Alex-Markham/causal-chamber/hardware/lasercuts/lasercut_lt_mk_1.pdf

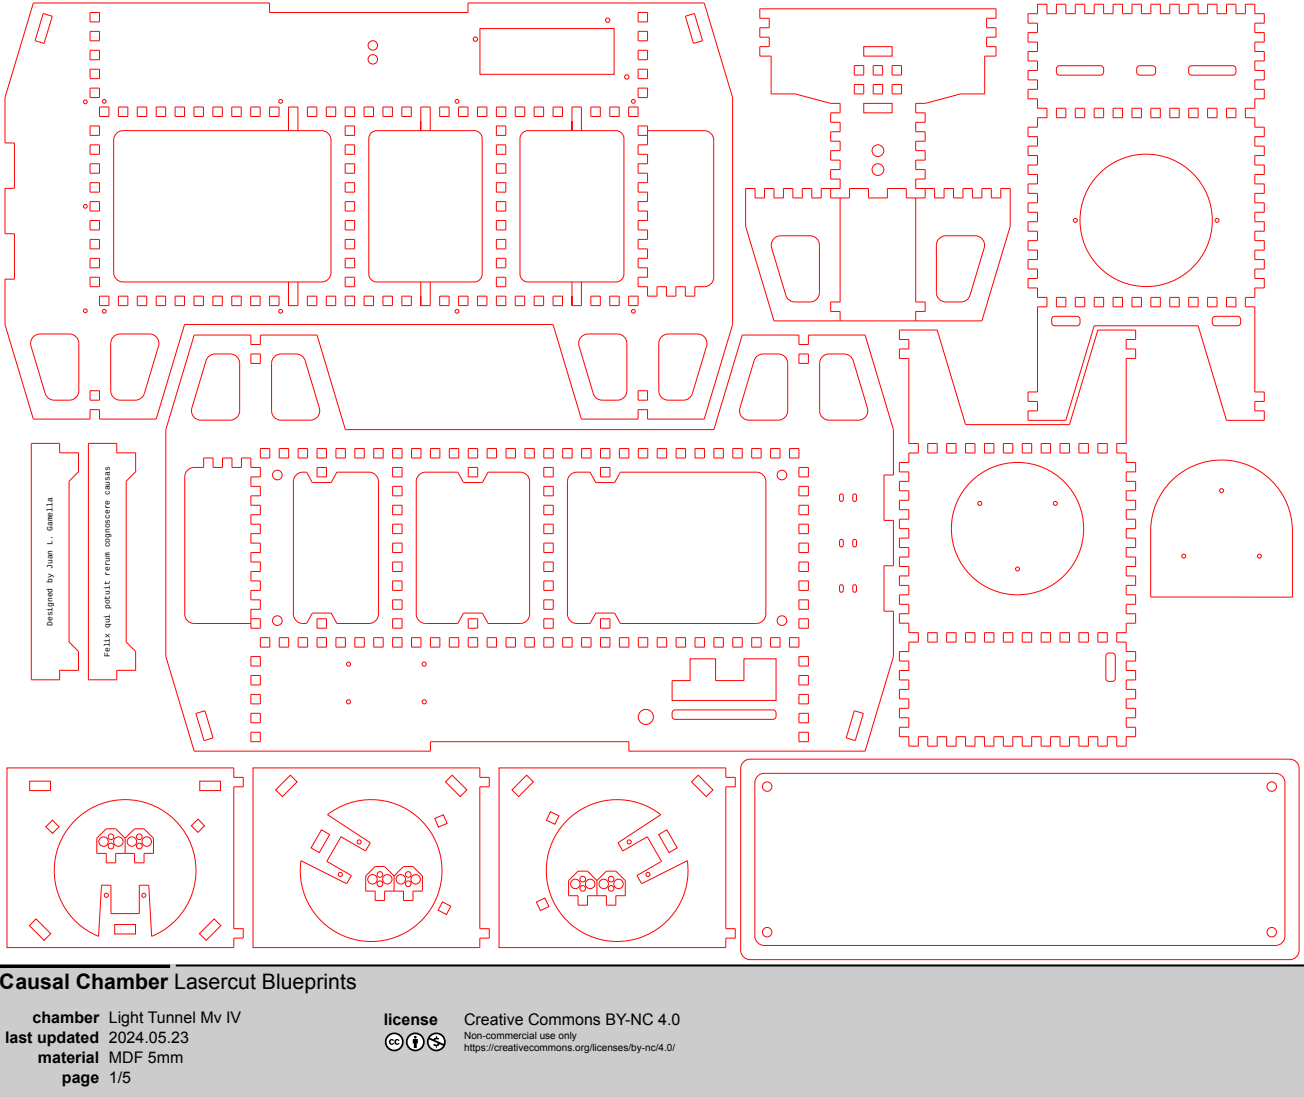
[picture p1: page 1]
chamber last updated material page; license; Creative Commons BY-NC 4.0

Felix qui potuit rerum cognoscere causas

Designed by Juan L. Gamella

Causal Chamber Lasercut Blueprints

Light Tunnel Mv IV
MDF 5mm

Non-commercial use only
https://creativecommons.org/licenses/by-nc/4.0/

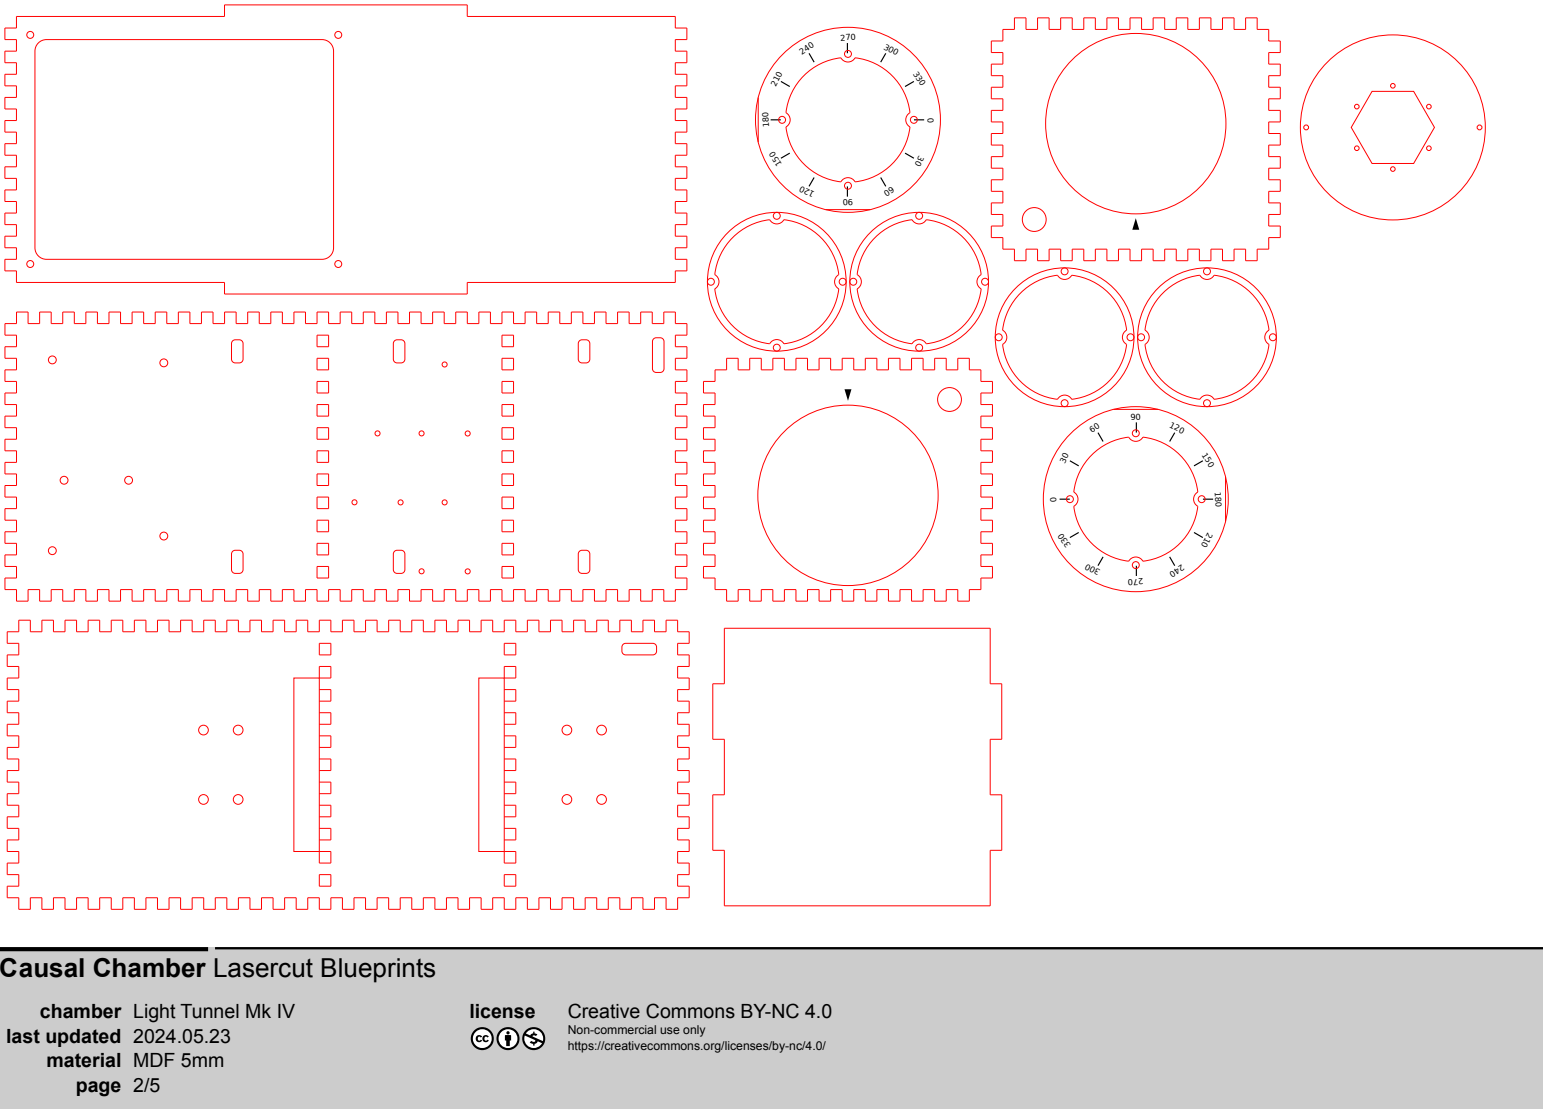
[picture p2: page 2]
chamber last updated; license; Creative Commons BY-NC 4.0

Causal Chamber Lasercut Blueprints

Light Tunnel Mk IV
MDF 5mm

Non-commercial use only
https://creativecommons.org/licenses/by-nc/4.0/

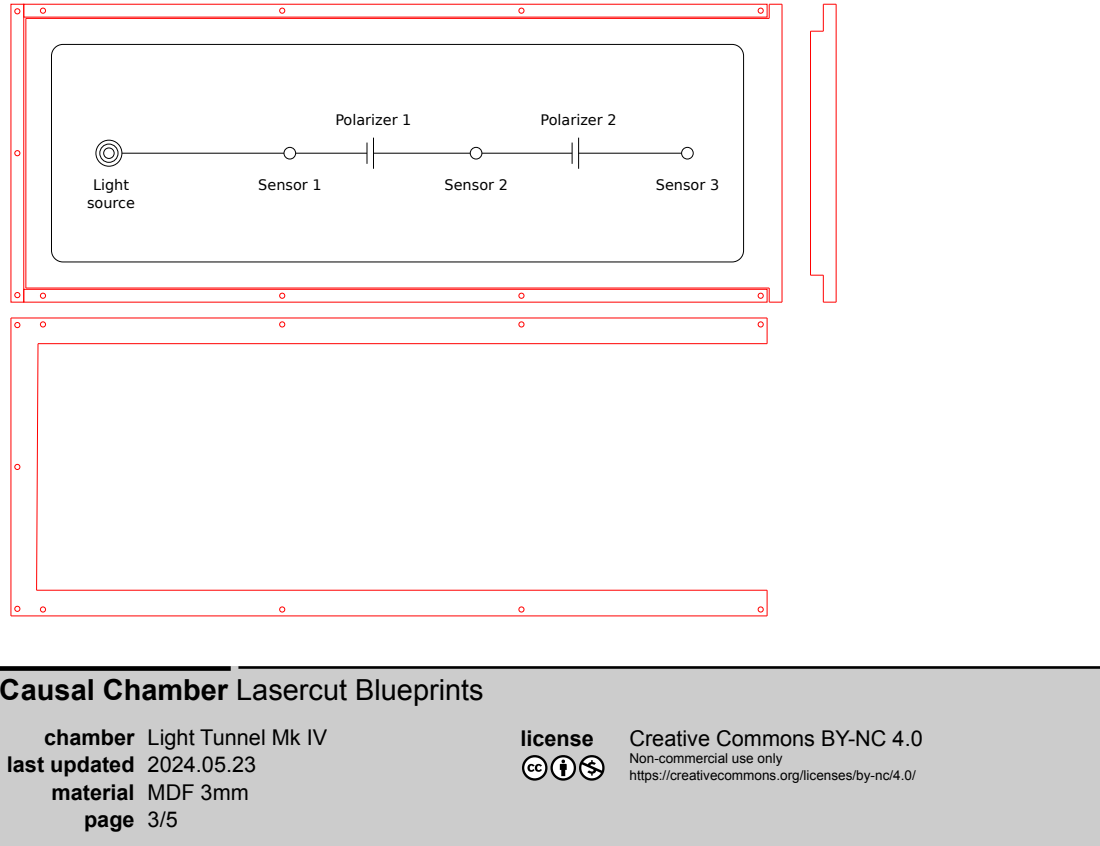
[picture p3: page 3]
chamber last updated; Sensor 1; Polarizer 1; Light source; Polarizer 2; Sensor 2; Sensor 3; license; Creative Commons BY-NC 4.0

Causal Chamber Lasercut Blueprints

Light Tunnel Mk IV
MDF 3mm

Non-commercial use only
https://creativecommons.org/licenses/by-nc/4.0/

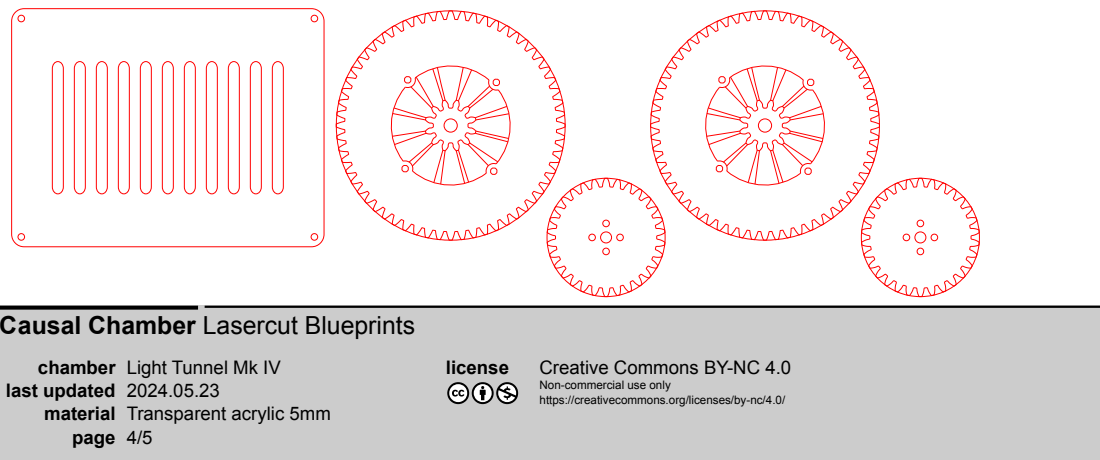
[picture p4: page 4]
chamber last updated material; license; Creative Commons BY-NC 4.0

Causal Chamber Lasercut Blueprints

Light Tunnel Mk IV
Transparent acrylic 5mm

Non-commercial use only
https://creativecommons.org/licenses/by-nc/4.0/

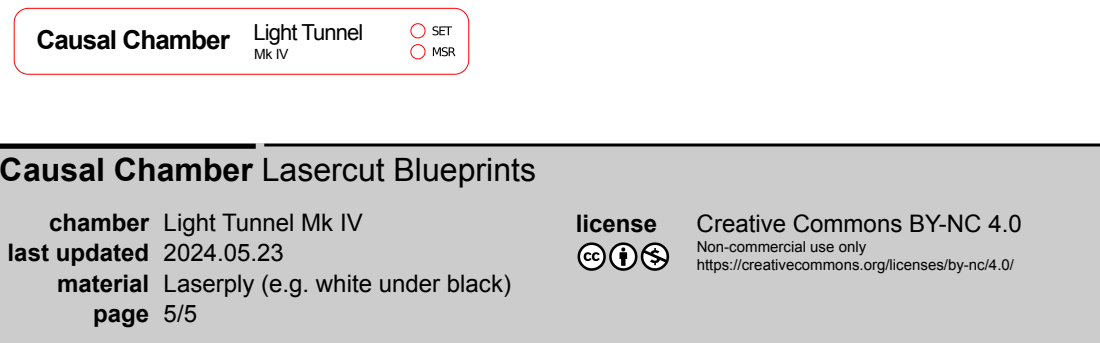
[picture p5: page 5]
chamber last updated material page; license; Creative Commons BY-NC 4.0

Causal Chamber Light Tunnel

Causal Chamber Lasercut Blueprints

Light Tunnel Mk IV
Laserply (e.g. white under black)

Non-commercial use only
https://creativecommons.org/licenses/by-nc/4.0/
