Alex-Markham/causal-chamber/hardware/lasercuts/lasercut_wt_mk_1.pdf

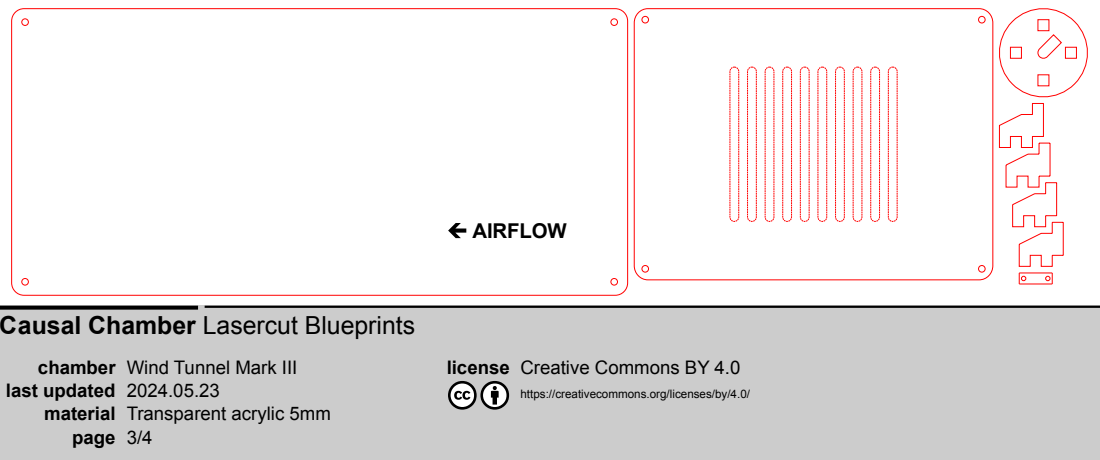
[picture p6: page 1]
AIRFLOW; chamber last updated material page

Causal Chamber Lasercut Blueprints

Wind Tunnel Mark III
Transparent acrylic 5mm

license Creative Commons BY 4.0

https://creativecommons.org/licenses/by/4.0/

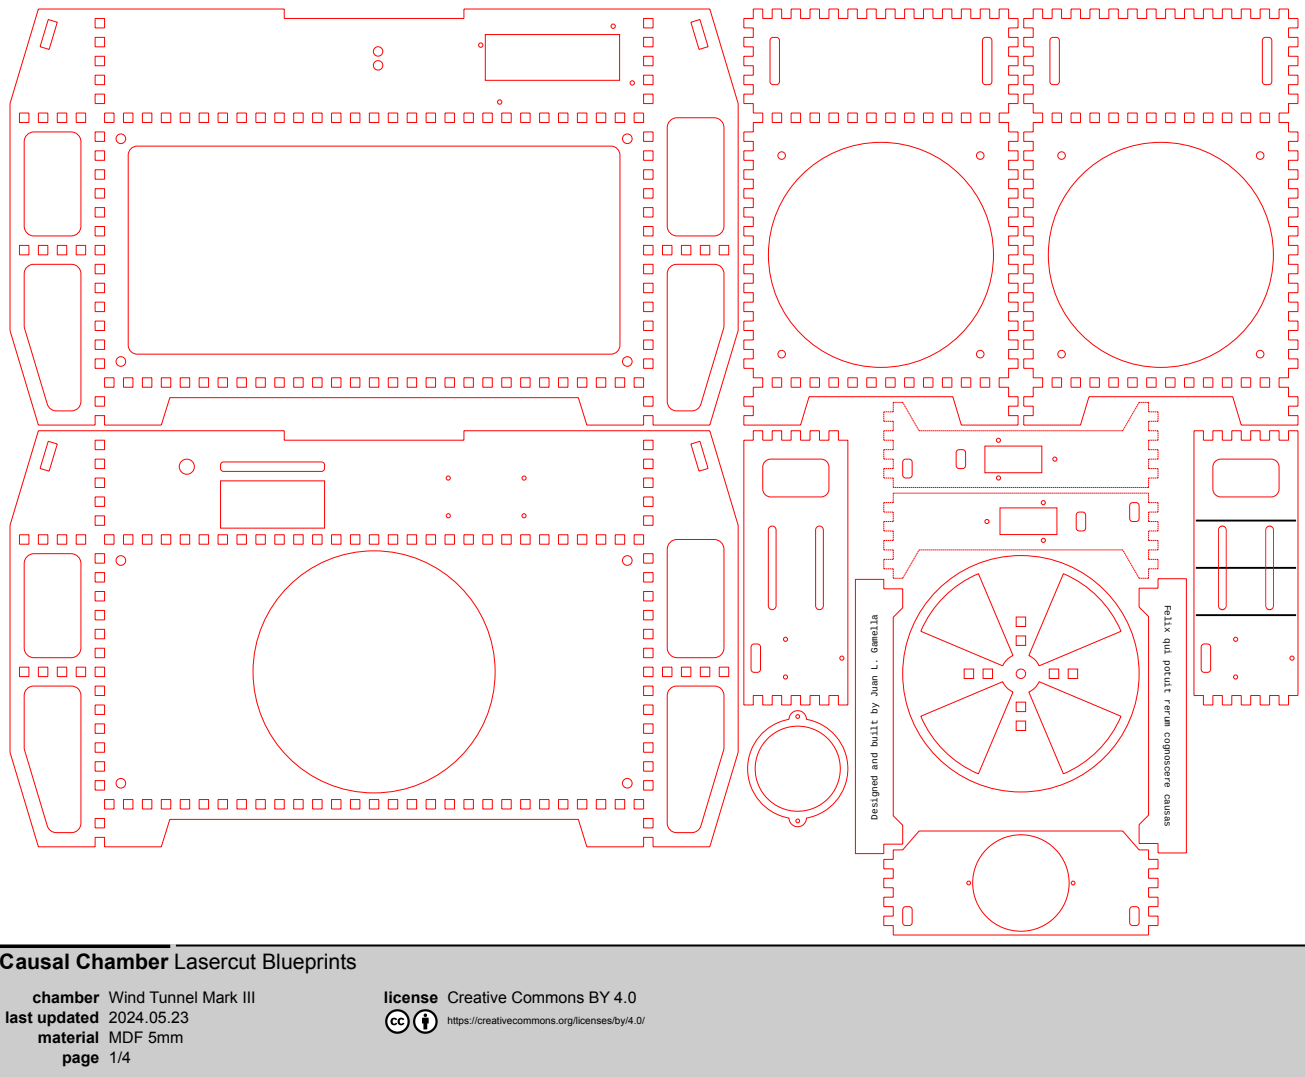
[picture p7: page 2]
chamber last updated material

Felix qui potuit rerum cognoscere causas

Designed and built by Juan L. Gamella

Causal Chamber Lasercut Blueprints

Wind Tunnel Mark III
MDF 5mm

license Creative Commons BY 4.0

https://creativecommons.org/licenses/by/4.0/

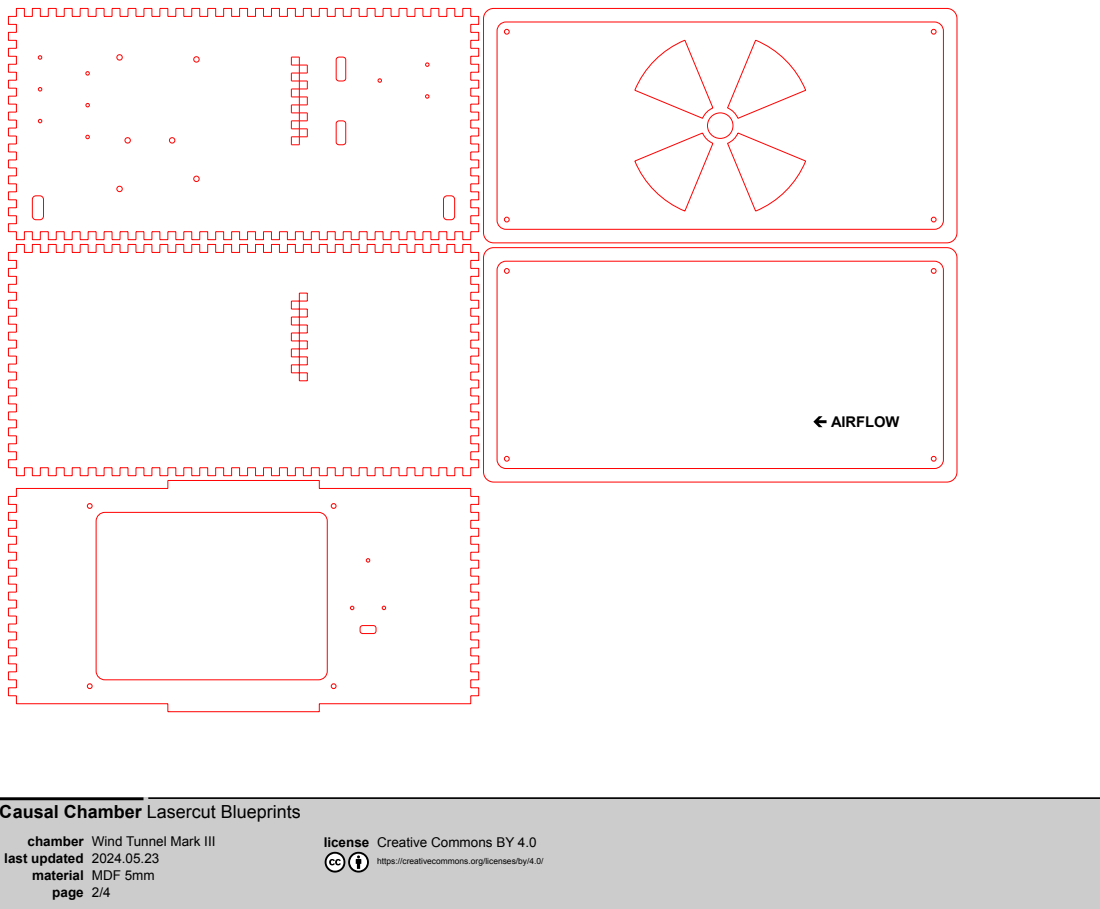
[picture p8: page 3]
AIRFLOW; chamber last updated material

Causal Chamber Lasercut Blueprints

Wind Tunnel Mark III
MDF 5mm

license Creative Commons BY 4.0

https://creativecommons.org/licenses/by/4.0/

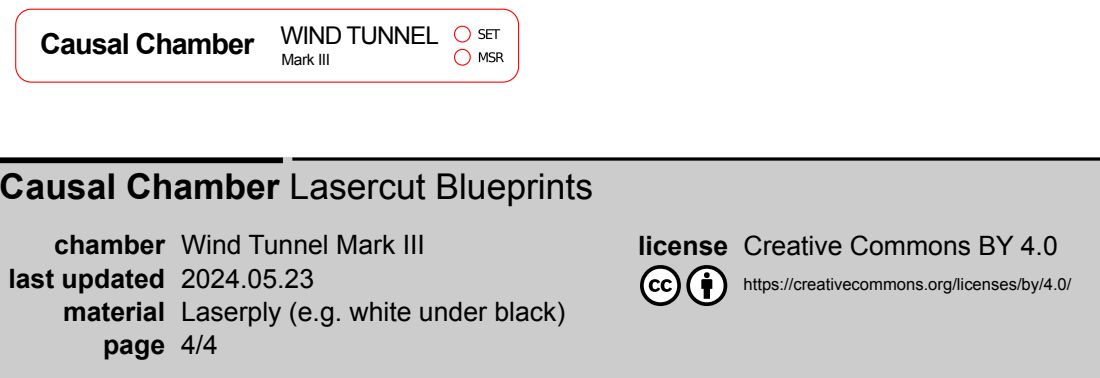
[picture p9: page 4]
Mark III; chamber last updated material page

Causal Chamber WIND TUNNEL

Causal Chamber Lasercut Blueprints

Wind Tunnel Mark III
Laserply (e.g. white under black)

license Creative Commons BY 4.0

https://creativecommons.org/licenses/by/4.0/
