Alex-Markham/causal-chamber/hardware/schematics/schematic_lt_mk_1.pdf

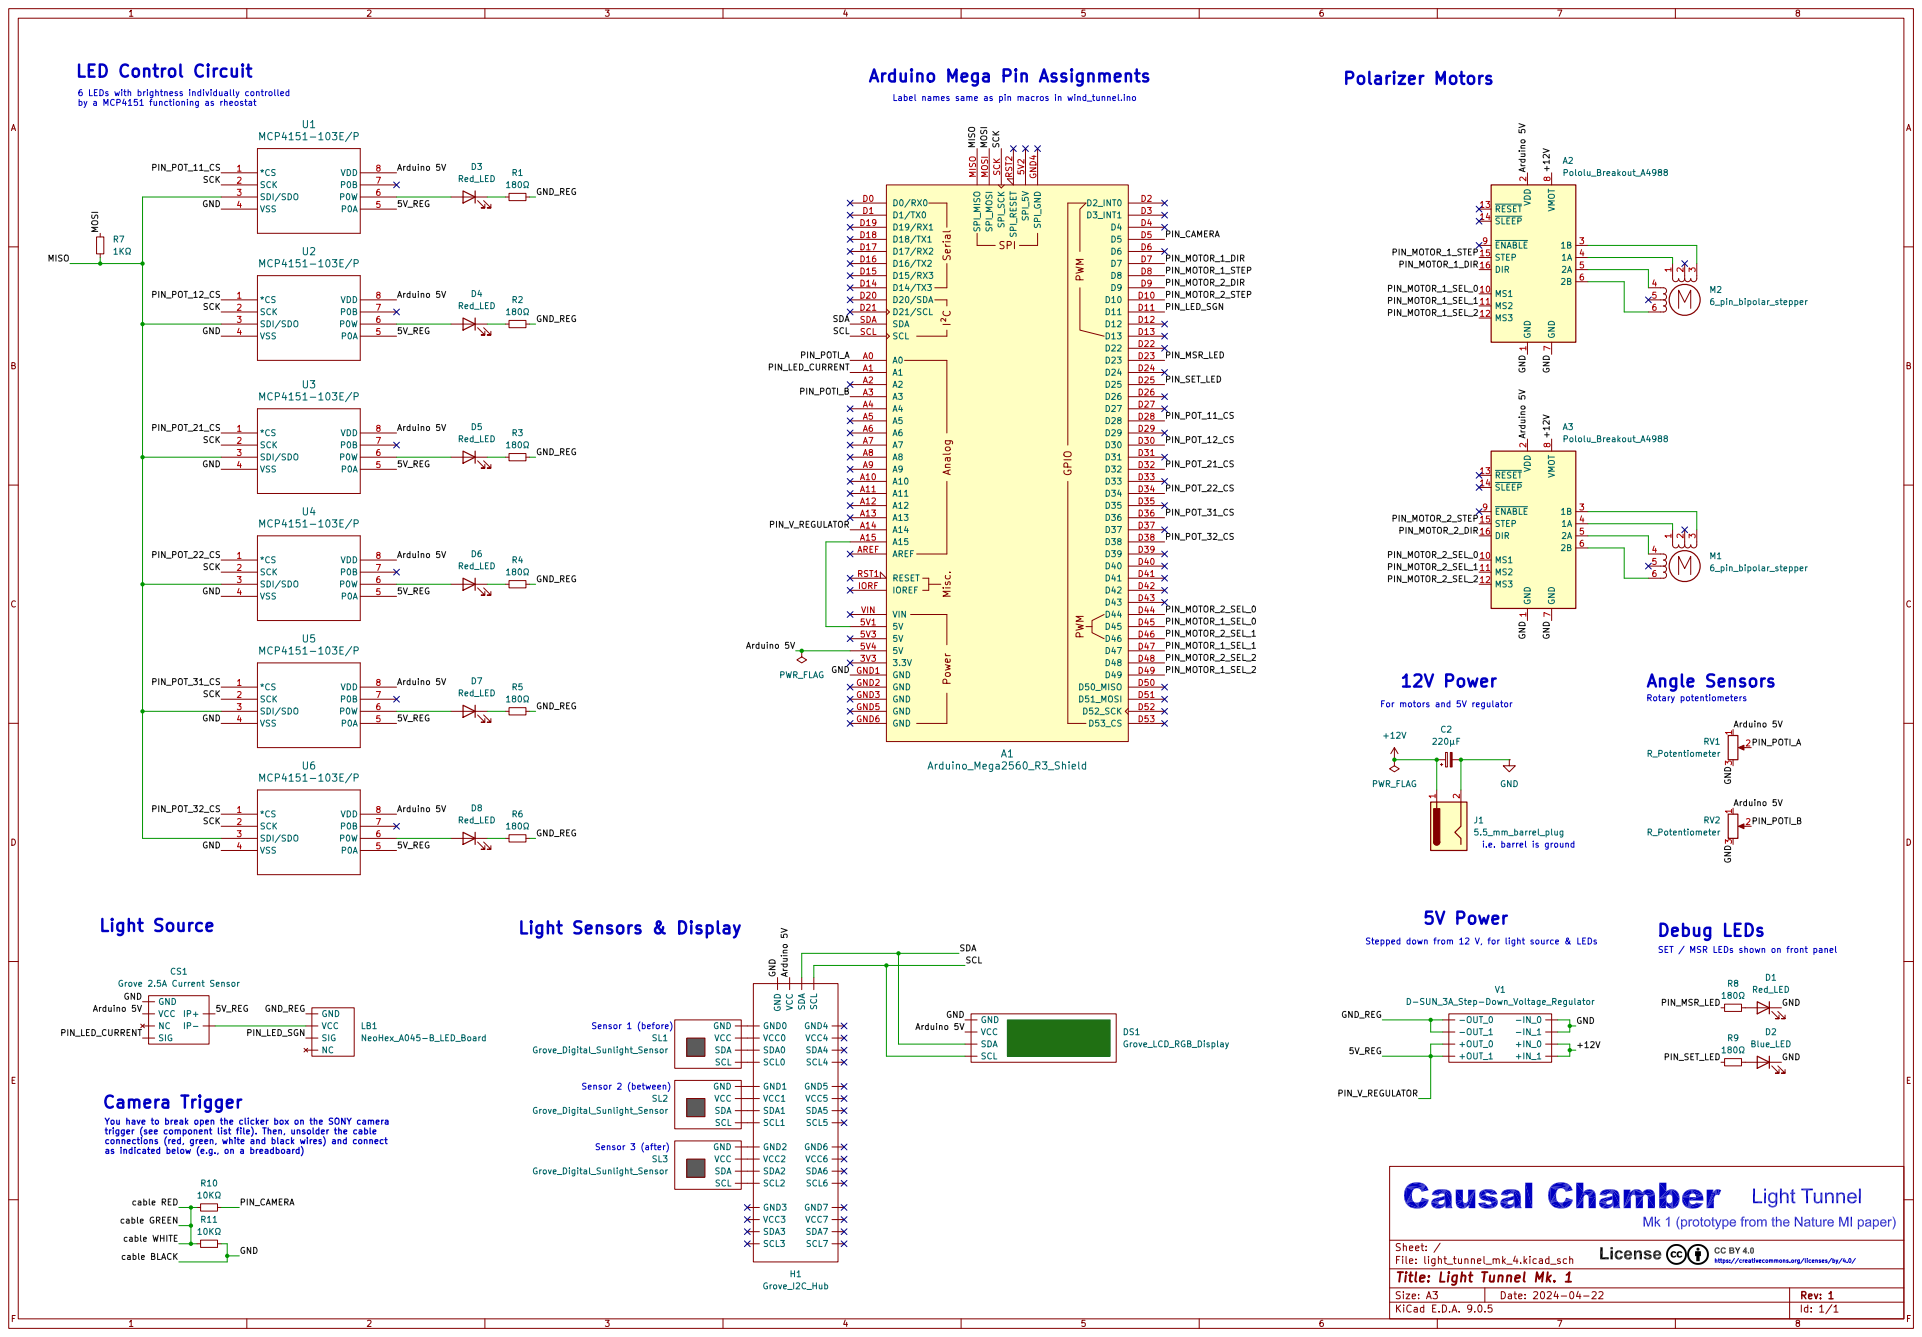
[picture p10: page 1]
