Alex-Markham/causal-chamber/hardware/schematics/schematic_wt_mk_1.pdf

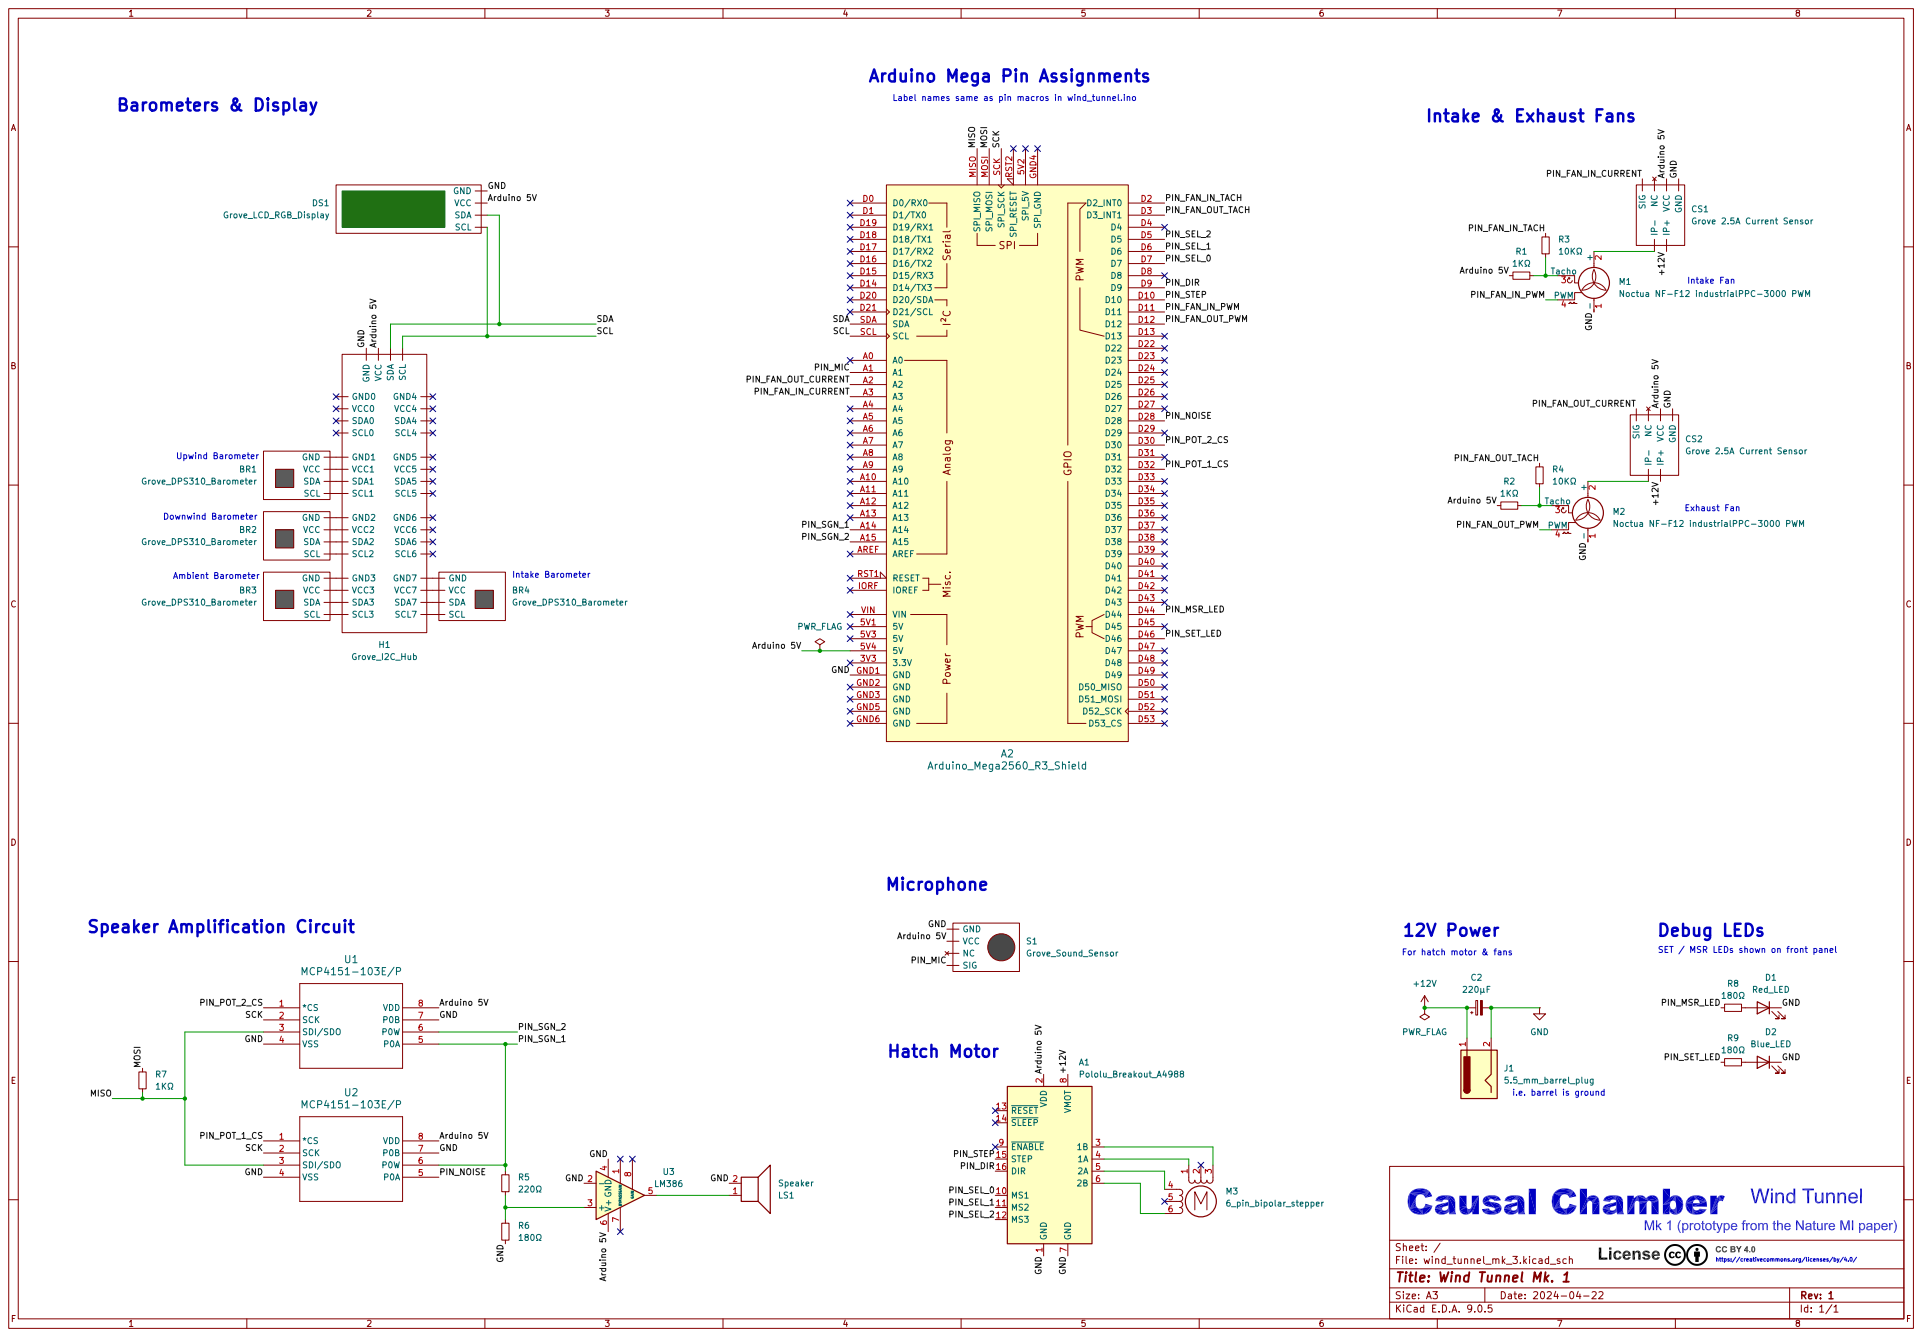
[picture p11: page 1]
