Alex-Markham/causal-chamber/(commit log)

2025-11-03 Re-upload of arduino code / control code
2025-11-03 Added schematics and bill of materials
    [bom_lt_mk_1.csv, bom_wt_mk_1.csv]
2025-11-03 Uploaded schematics and bill of materials
